2eno/omafon/(commit log)

2026-11-01 chore: Projektgerüst mit .gitignore, MIT-Lizenz und Abhängigkeiten
    requirements.txt enthält die Laufzeit-Pakete für den Pi, requirements-dev.txt
    nur PyYAML – Tests und Simulator kommen ohne Hardware-Bibliotheken aus.
    Claude-Session: https://claude.ai/code/session_01KaaAhLLYDS61gz6faZzMxm
2026-11-01 feat: Telefonsoftware mit Zustandsautomat, Simulator und Tests
    Sprechendes Telefon für Raspberry Pi Zero 2 W + SIM7600: Ziffernansage,
    Anrufe, SMS im PDU-Modus, Sprachwahl und Diktat (Vosk), Notrufkette,
    Watchdog. 22 Tests laufen ohne Hardware über Sim-Klassen.
    Die Beispielnummer des Arztes in config.example.yaml ist eine fiktive
    Nummer aus dem BNetzA-Bereich für Medienproduktionen (069 90009 xxx).
    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
2026-11-01 feat(cad): Tastenkappen und Tastenfront in OpenSCAD
    Parametrische Kappen für Cherry-MX-Taster (Ziffern mit Relief und
    optional Braille, Anrufen/Auflegen/Nachricht/Info/Notruf fühlbar
    unterscheidbar) sowie Tastenfront mit Taststegen. Dazu ein Vorschaubild.
    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
    [omafon_tasten.scad]
2026-11-01 ci: Tests mit Python 3.11/3.13 und STL-Export per OpenSCAD
    Job 'tests' läuft bei Push und Pull Request für Python 3.11 und 3.13.
    Job 'cad' rendert alle Teile aus cad/omafon_tasten.scad (Ziffern 0-9, *, #,
    anrufen, auflegen, nachricht, info, notruf, front) zu STL, bricht bei
    OpenSCAD-Warnungen ab und lädt die Dateien als Artefakt omafon-stl hoch.
    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
2026-11-01 docs: CLAUDE.md, Doku-Platzhalter und README mit Badges und Status
    - CLAUDE.md: Überblick, Module, Befehle und Projektregeln
    (sofortige Ansage, Notruf ohne I²C, Ansagen nur im P-Dict + prerender)
    - docs/stueckliste.md und docs/verkabelung.md als Platzhalter
    - README: CI-Badge, Vorschaubild des Tastenfelds, Abschnitt Status
    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
2026-11-01 feat: neue SMS per Gong und LED ankündigen statt automatisch vorzulesen
    Neue Nachrichten werden nicht mehr sofort vorgelesen. Stattdessen:
    - Gong bei Eingang, Erinnerung alle news_signal_minutes (Standard 10),
    solange ungelesene Nachrichten da sind (0 = nur einmal)
    - LED blinkt langsam (1 s an, 2 s aus), abschaltbar mit news_led
    - kein Gong im Gespräch, in laufenden Abläufen oder in der Ruhezeit;
    nachts nur LED, Gong nach Ende der Ruhezeit
    - vorgelesen wird erst mit der Nachricht-Taste
    Tests angepasst und um Erinnerung/LED ergänzt (23 Tests).
    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
2026-11-01 feat(cad): zweifarbige Tastenkappen mit kontrastreichen Zeichen
    Kappe und Zeichen sind getrennte Körper (farbteil = alles | kappe | zeichen),
    damit Mehrmaterial-Drucker z. B. schwarze Ziffern auf weißen Kappen drucken.
    Farbpaare zentral in FARBEN: Schwarz auf Weiß (Ziffern, Nachricht, Info),
    Schwarz auf Gelb (Anrufen), Weiß auf Schwarz (Auflegen), Weiß auf Rot
    (Notruf-Noppen). Vorschaubild mit den neuen Farben neu gerendert.
    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
    [omafon_tasten.scad]
2026-11-01 ci: Tastenkappen zusätzlich als Kappe/Zeichen für Mehrfarbdruck rendern
    Artefakt omafon-stl enthält jetzt einfarbig/ (alle Teile inkl. Front) und
    zweifarbig/ (*_kappe.stl und *_zeichen.stl je Taste).
    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
2026-11-01 docs: Nachrichten-Signal und zweifarbige Tasten beschreiben
    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
2026-11-01 refactor: Telefonie-Schnittstelle TelephonyBackend einführen
    Neue Datei omafon/telephony.py mit TelephonyBackend (start, dial, answer,
    hangup, dtmf, signal, alive; optional send_sms, read_sms, gps_position,
    online/status_words) und create_backend() für die Auswahl über
    config.yaml (backend: sim7600 | sip).
    Modem und SimModem sind jetzt das Backend "sim7600"; ModemEvent und
    ModemError bleiben über omafon.modem importierbar. Verhalten unverändert,
    alle Tests grün.
    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
2026-11-02 feat(fritz): Telefonbuch und Anrufbeantworter per TR-064
    FritzBox (über fritzconnection) liest das Telefonbuch (X_AVM-DE_OnTel:
    GetPhonebook) und die AB-Nachrichten (X_AVM-DE_TAM: GetMessageList,
    MarkMessage, DeleteMessage) und lädt Aufnahmen über download.lua mit der
    Sitzungs-ID aus der Listen-URL. XML-Auswertung als reine Funktionen,
    SimFritzBox für Simulator und Tests.
    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
2026-11-02 feat(notify): Telegram und E-Mail als Ersatz für SMS
    Optional und standardmäßig aus. Empfänger sind Kontakte mit
    telegram_chat_id oder email. Wird im Festnetz-Betrieb für den
    Notruf-Hinweis und diktierte Nachrichten genutzt.
    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
2026-11-02 feat(sip): Festnetz-Backend über baresip an der Fritz!Box
    BaresipBackend startet baresip, steuert es über ctrl_tcp (Netstring-JSON:
    dial, accept, hangup, sndcode) und übersetzt REGISTER_*/CALL_* in die
    bekannten Ereignisse ring/clip/call_begin/call_end/busy.
    - Klingeln wird wie beim Modem alle 3 s wiederholt; baresip klingelt nicht.
    - Verbindung: Registrierung + WLAN-Zustand; nach 10 s link_lost, danach
    neu registrieren, baresip neu starten, WLAN neu verbinden; link_ok zurück.
    - Anrufbeantworter wird regelmäßig abgefragt; neue Nachrichten kommen als
    VoiceMessage mit WAV-Datei (fremdes Format per ffmpeg), danach markiert.
    - Telefonbuch der Fritz!Box landet in cfg.phonebook. Der SIP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
2026-11-02 feat: Phone für Festnetz – Anrufbeantworter, Verbindungsansage, Ladeschale
    Kleine, abschaltbare Ergänzungen; das Mobilfunk-Verhalten bleibt gleich:
    - AB-Nachrichten wie SMS ankündigen, beim Vorlesen die Aufnahme abspielen;
    alte Aufnahmen werden mit dem Posteingang aufgeräumt.
    - link_lost/link_ok ansagen, alle link_reminder_minutes erinnern; Wählen
    ohne Verbindung sagt das sofort an statt stumm zu scheitern; Info-Taste
    nennt den Verbindungszustand.
    - Notruf versucht die Kette auch ohne Verbindung und sagt den Zustand an.
    - Diktat nur, wenn ein Versandweg zur gewählten Person existiert.
    - Ladeschale: answer_on_lift, dock_in_call (ignore/hangup/handsfree),
    dock_speaker (in der S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
    [audio.py, config.py, phone.py]
2026-11-02 test: SIP-Backend gegen nachgebautes baresip und Festnetz-Abläufe
    29 Tests: Protokoll und Hilfsfunktionen, TR-064-XML, Telegram-Aufruf,
    Verbindungsverlust mit Schonfrist und Eskalation, WLAN-Abriss, Absturz
    von baresip, AB-Abruf ohne Doppelung, Namensansage nur aus dem
    Telefonbuch, Notrufkette bis 112 mit Push statt SMS, Abheben/Einstellen
    in der Ladeschale, Diktat per Push.
    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
2026-11-02 chore: Beispielkonfiguration für die Festnetz-Variante
    Nur Platzhalter für Kennwörter; Test prüft, dass keine echten
    Zugangsdaten in den Beispieldateien stehen.
    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
2026-11-02 feat(cad): Ladeschale mit Lautsprecher für die Festnetz-Variante
    Parametrische Schale: nach hinten geneigter Steckschacht mit Einführ-
    trichter (blind auffindbar) und Kodierrippe (Telefon passt nur richtig
    herum), Träger für 5 Federkontakte (+5V, 2x GND, LS+, LS-) mit zwei
    Haltemagneten, Schallführung für einen 50-mm-Lautsprecher unter dem Grill,
    USB-C-Halter, Tastrillen vorn, Bodenplatte mit Gewichtskammer und
    Gummifüßen, Kontaktplatte für die Telefonunterseite.
    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
    [omafon_ladeschale.scad]
2026-11-02 docs: Festnetz-Recherche mit Bewertung DECT vs. WLAN-SIP
    Anmeldung an der Fritz!Box (GAP-DECT, IP-Telefon), TR-064 (Telefonbuch,
    Anrufliste, Anrufbeantworter), DECT-Module (SC14CVMDECT, NR+), Zulassung
    (FuAG/RED, Antennenumbau), Alternativen, Bewertungstabelle, Empfehlung
    WLAN-SIP, Einrichtung der Fritz!Box, offene Fragen, Quellen.
    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
2026-11-02 docs: Stückliste, Strombilanz und Verkabelung der Festnetz-Variante
    Ohne Modem und GPS, mit Ladeschale (Federkontakte, Relais schaltet den
    Lautsprecher ohne Software auf die Schale), Akkurechnung, Hinweise zur
    WLAN-Platinenantenne, ungefähre Preise.
    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
2026-11-02 docs: README und CLAUDE.md um die Festnetz-Variante ergänzen
    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
2026-11-02 fix: Verbindungsverlust nachts nicht ungefragt ansagen
    Passend zur Ruhezeit (nachts kein Gong): link_lost/link_ok werden in
    quiet_hours nicht gesprochen. Jeder Tastendruck bzw. Wählversuch sagt den
    Zustand weiterhin sofort an, und nach der Ruhezeit kommt die Erinnerung.
    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
    [phone.py]
2026-11-02 feat(phone): Backend wählt die Ansage für Verbindungsereignisse
    link_lost/link_ok dürfen in data einen P-Schlüssel nennen; die
    Offline-Ansage kommt über offline_key des Backends. Neue Texte für das
    Hybridgerät (Kein Netz, Telefonieren geht wieder, Zu Hause/Unterwegs).
    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
2026-11-02 feat(hybrid): ein Gerät für Fritz!Box zu Hause und Mobilfunk unterwegs
    HybridBackend betreibt BaresipBackend und Modem gleichzeitig und leitet
    deren Ereignisse gefiltert an Phone weiter:
    - wer zuerst klingelt, bekommt das Gespräch; der andere Weg wird solange
    abgewiesen
    - Wählen über prefer (Standard Festnetz), sonst/ bei Fehler der andere
    Weg; 110/112 zu Hause über Festnetz (Adresse), sonst Mobilfunk, auch
    ohne eigenes Netz
    - SMS und Anrufbeantworter in einem Posteingang (Indizes umgeschlüsselt)
    - "Kein Netz" erst, wenn beide Wege fehlen; Wechsel optional ansagen
    - Sparmodus home_modem: off schaltet den Mobilfunk bei stabiler
    Fritz!Box in den Flugmodus und weckt ihn beim Verl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
2026-11-02 test: Hybrid-Routing, Notruf, Zweitanruf, Sparmodus, Kein-Netz-Ansage
    14 Tests mit echtem SIP-Backend gegen FakeBaresip und SimModem.
    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
2026-11-02 feat(hybrid): bei schwachem WLAN über Mobilfunk telefonieren
    Am Rand der WLAN-Reichweite (Garten) ist die Fritz!Box noch erreichbar,
    ein Gespräch würde aber abreißen. Unter weak_wifi_dbm (Standard -75 dBm)
    wählt das Gerät zuerst über Mobilfunk, auch beim Notruf.
    Geheimnis-Test deckt jetzt auch die Hybrid-Beispielkonfiguration ab.
    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
2026-11-02 docs: Design des Hybridgeräts (Festnetz zu Hause, Handy unterwegs)
    Szenarien, Entscheidungstabelle fürs Routing, Rufnummernkonzept und
    Sparmodus, Grenzen (kein Weiterreichen, zwei Absendernummern),
    Hardware-Abweichungen mit Preisen, Strombilanz, Antennenanordnung,
    Gehäuse/Ladeschale, offene Fragen. README und CLAUDE.md ergänzt.
    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
2026-11-02 feat(cad): gemeinsame Maße für Handteil und Ladeschale
    omafon_masse.scad legt Außenmaße je Variante (festnetz 30 mm, mobil/
    hybrid 36 mm dick), Ladekontakte, Magnete und Kodierung an einer Stelle
    fest. omafon_tasten.scad gibt Frontmaße und Tastenpositionen als
    Funktionen heraus, damit das Gehäuse sie per use übernehmen kann.
    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
    [omafon_masse.scad, omafon_tasten.scad]
2026-11-02 feat(cad): druckbares Gehäuse für das Handteil
    Deckel (Tastenfenster, Hörer mit fühlbarem Ring, LED, Mikrofon, Rasthaken
    für die Tastenplatte, GNSS-Rahmen bei mobil/hybrid), Wanne (Notrufmulde
    mit Klappe, Scharnier und Reedkontakt, Lautsprecher, Akkufach, Ladekontakte
    und Stahlscheiben, Kodiernut, Lautstärketasten mit Schienen, Pi-Halter,
    Schraubdome mit Gewindeeinsätzen), Tastenplatte mit Kragen, Akkudeckel
    mit zwei Senkschrauben, Notrufklappe, Lautstärketasten +/-.
    Alle STL in Druckrichtung ohne Stützen; Kollisionen per Schnitt geprüft.
    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
    [omafon_gehaeuse.scad]
2026-11-02 refactor(cad): Ladeschale aus den gemeinsamen Maßen ableiten
    Schacht, Breite und Tiefe folgen jetzt dem echten Handteil (94 mm breit,
    30/36 mm dick) statt fester Annahmen; doppelte Kontakt- und Kodiermaße
    entfallen.
    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
    [omafon_ladeschale.scad]
2026-11-02 ci: komplettes Druckpaket je Variante als Artefakt
    tasten/ (ein- und zweifarbig), gehaeuse/festnetz, gehaeuse/mobil_hybrid,
    ladeschale/festnetz, ladeschale/mobil_hybrid und LIESMICH.md mit Druck-
    und Montageanleitung. Die alte Tastenfront ohne Kragen entfällt; sie ist
    als tastenplatte Teil des Gehäuses.
    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
2026-11-02 docs: Druckteile, Kaufteile und Zusammenbau
    docs/druckteile.md: Teileliste mit Farben und Druckrichtung, Druck-
    einstellungen, Schrauben/Einsätze/Magnete, Montage von Handteil und
    Ladeschale, Anpassen, offene Punkte. README mit Vorschaubildern,
    CLAUDE.md um die CAD-Regeln ergänzt.
    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
2026-11-02 feat(cad): erhabene Hörmuschel als eigenes Druckteil
    3,5 mm hoher Ring (Ø 24/16 mm) um den Hörer, am besten aus TPU: führt
    das Ohr an die richtige Stelle und dichtet ab (besser verstehen).
    Sitzt in einer 1 mm tiefen Ringmulde im Deckel.
    Behebt nebenbei: der bisherige 0,8-mm-Tastring stand auf der Vorderseite
    vor, die beim Deckel aufs Druckbett kommt – sie ist jetzt wieder plan.
    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
    [omafon_gehaeuse.scad]
2026-11-02 feat: im Gespräch legt die Auflegetaste nur gehalten auf
    Am Ohr streift die Wange leicht die Auflegetaste. Im Gespräch und beim
    Rufaufbau zählt sie deshalb erst nach hangup_hold_s (Standard 0,5 s) oder
    langem Druck; ein kurzer Druck sagt einmal pro Gespräch "Zum Auflegen die
    schwarze Taste etwas länger drücken." Einstellen in die Schale legt
    weiter sofort auf, 0 schaltet die Sperre ab.
    KeyEvent trägt dazu die Haltedauer (held) bei short/up.
    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
    [config.festnetz.example.yaml, config.hybrid.example.yaml, config.py, hardware.py, phone.py]
2026-11-02 feat(cad): Hörerkopf – Ohr liegt höher als die Tasten
    Neues Druckteil hoererkopf: 15 mm hohes Kopfteil über den Tasten mit
    Schallrohr (zentriert in der Deckelmulde) und LED-Lichtrohr. Die
    Hörmuschel (jetzt 19,6/14 mm, 3 mm) sitzt obendrauf und steht damit
    deutlich über der höchsten Tastenkappe – die Wange drückt beim
    Telefonieren keine Taste. Ladeschale unverändert (Kopfende steckt nicht
    im Schacht).
    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
    [omafon_gehaeuse.scad]
2026-11-02 fix(cad): druckfertige Überarbeitung nach Kollisions- und Druckprüfung
    Gefunden mit einem Prüfmodell (MX-Taster, Kappen in Ruhe und gedrückt,
    Elektronik als Platzhalter) und einer Überhanganalyse der STL:
    - Separate Tastenplatte passte nicht unter den Deckel (Innenrundung),
    Rasthaken wären zu steif gewesen: Schalterplatte ist jetzt Teil des
    Deckels (Ausschnitt 14,1 mm, innen Taschen bis 1,6 mm = 8 Lagen à 0,2).
    Taststege als optionales flaches Gitter (1,2 mm, gedrückte Kappen frei).
    - Hörerkopf 18 mm: Muschel bleibt > 3 mm über der höchsten Kappe.
    - Hybrid: Tasterpins hätten den Modem-HAT gestreift – jetzt frei.
    - Notrufmulde 12 mm tiefer: Taster kollidierte mit dem Hör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
    [omafon_gehaeuse.scad, omafon_tasten.scad]
2026-11-02 docs: Druckanleitung auf den druckfertigen Stand
    Prüfstück zuerst, 0,2-mm-Schicht für Deckel und Wanne (Schalterplatten),
    keine Lochkompensation, Tastengitter optional, neue Montage der Taster.
    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
2026-11-02 refactor!: reine Handy-Variante entfällt – nur noch Festnetz und Hybrid
    - backend: sip (Standard) oder hybrid; "sim7600" ist nicht mehr wählbar.
    modem.py/pdu.py bleiben als Mobilfunkteil des Hybrids erhalten.
    - config.example.yaml (Handy) entfernt; Kern-Tests laufen mit der
    Hybrid-Vorlage, die dafür admin (STATUS-SMS) beim Enkel bekommt.
    - CAD: variante festnetz | hybrid, Abbruch mit klarer Meldung bei
    anderen Werten; STL-Paket unter gehaeuse/hybrid, ladeschale/hybrid.
    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
    [omafon_gehaeuse.scad, omafon_masse.scad]
2026-11-02 docs: Stückliste und Verkabelung für Festnetz und Hybrid
    Stückliste: Elektronik, Audio, Bedienung, Strom, Ladeschale, Mechanik,
    Verbrauchsmaterial je Variante mit Preisschätzung (ca. 175–215 € bzw.
    300–350 €). Verkabelung: Übersicht, Pi-Pinbelegung, MCP23017-Tastenbelegung,
    Eingänge, MOSFET-Ausgänge, Audio mit Relais und (Hybrid) passivem Mischer
    für den Modem-Ton, Stromversorgung, Ladeschale, Inbetriebnahme.
    Kern-Tests nutzen die Hybrid-Vorlage; neuer Test hält die Pinbelegung in
    der Doku und hardware.py gleich.
    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
2026-11-02 docs: README, CLAUDE.md und Druckanleitung auf zwei Varianten
    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
2026-11-02 docs: Druckteile nach Druckeinstellungen gruppiert
    Vier Gruppen mit je einer Einstellungstabelle (PETG 0,2 mm; PETG 0,2 mm
    stehend mit Brim; Tastenkappen 0,12 mm; TPU) und Druckplatten nach Farbe,
    gegen die STL-Maße auf 220 x 220 mm geprüft. Ladeschale druckt jetzt mit
    den Gehäuse-Einstellungen (25 % statt 30 % Füllung), damit Gehäuse und
    Schale eine Gruppe bilden.
    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
2026-11-10 English as the default language for code, comments and docs (#2)
    * Translate Python comments, docstrings and log messages to English
    Spoken announcements, SMS/notification texts and number words stay German
    (the phone talks to a German user). Tests: 71 passed.
    Claude-Session: https://claude.ai/code/session_01KaaAhMcvEnxFFjuA1Z1VWt
    * Translate config comments, CI step names, requirements and systemd unit
    STL package now contains README.md (English) and LIESMICH.md (German).
    Claude-Session: https://claude.ai/code/session_01KaaAhMcvEnxFFjuA1Z1VWt
    * Translate CAD comments and con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
    [omafon_gehaeuse.scad, omafon_ladeschale.scad, omafon_masse.scad, omafon_tasten.scad]
